tr1xumxmk-ops/CyberCar-main-/infos/Screenshot 2026-10-22 002236.png

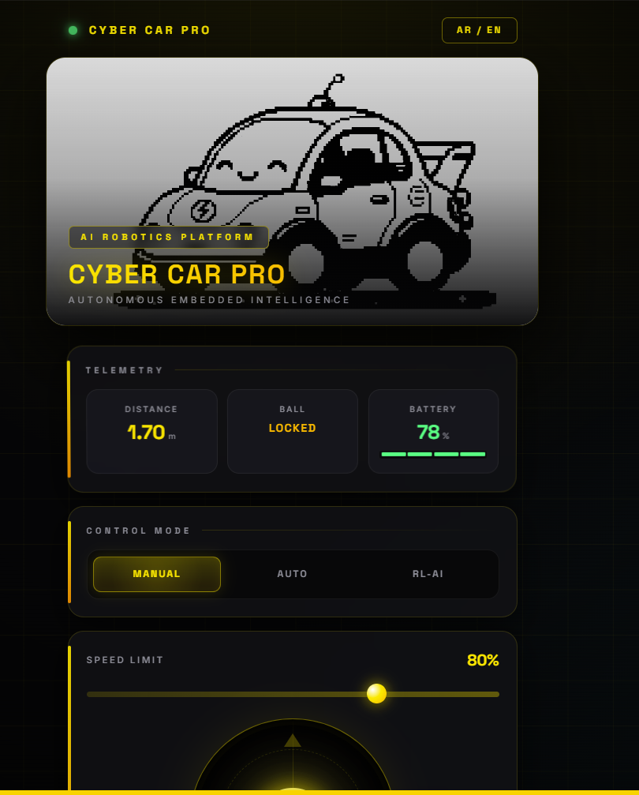
infos/Screenshot 2026-10-22 002236.png
