tr1xumxmk-ops/CyberCar-main-/CyberCar/wiring_handels/CyberCarPro_dashboard_preview.html

CYBER CAR PRO

AR / EN

Cyber Car

AI ROBOTICS PLATFORM

# CYBER CAR PRO

AUTONOMOUS EMBEDDED INTELLIGENCE

TELEMETRY

Distance

--cm

Ball

LOCKED

Battery

--%

CONTROL MODE

MANUAL AUTO RL-AI

Updates

0

Episodes

0

Best Reward

Exploration 50%

SPEED LIMIT 80%

QUICK ACTIONS

RELEASE BALL LOCK BALL HORN DANCE EMERGENCY BRAKE

AL-IRAQIA UNIVERSITY

## AI & ROBOTICS ENGINEERING

Supervised by the SPARK Team — Department of Artificial Intelligence & Robotics

HN

Haider Nadhir

Team Lead

AA

Ahmed Amjad

AI Engineer

BF

Baraa Fadhel

Robotics Engineer

AS

Ayat Saeed

Systems Engineer

Designed & Engineered by AI & Robotics Engineers
© 2026 CYBER CAR PRO — Under SPARK Team Supervision

COMMAND SENT
