tr1xumxmk-ops/CyberCar-main-/CyberCar/wiring_handels/CyberCarPro_Guide (2).html

دليل التوصيل والتشغيل • ESP32-S2

# خلّي Cyber Car Pro تشتغل خطوة بخطوة

دليل عربي عملي لربط المحركات والحساسات والطاقة، ثم رفع البرنامج والاتصال بالسيارة من الموبايل عبر شبكة Wi‑Fi الخاصة بها.

ابدأ بالتوصيلاتربط الموبايل

## ١. القطع المطلوبة

تأكد من وجود هذه القطع قبل البدء.

### 🧠 وحدة التحكم

LOLIN / WEMOS ESP32-S2 Mini، وهي عقل السيارة وتستضيف صفحة التحكم.

### ⚙️ الحركة

درايفر محركات L298N ومحركان DC مع عجلات.

### 📡 استشعار المسافة

حساس HC-SR04 لقياس العوائق أمام السيارة.

### ↔️ السيرفو

عدد ٢ سيرفو SG90 أو MG90S: واحد للمسح، والثاني لآلية تحرير الكرة.

### 🔋 الطاقة

بطارية 2S LiPo بجهد 7.4V ومحوّل خافض إلى 5V بتيار 2A أو أكثر.

### 💡 إضافات

ثلاثة LEDs ومقاومات 220Ω، صفارة، ومقاومتان لقياس جهد البطارية.

سلامة أولاً: افصل البطارية أثناء التوصيل. لا توصل 5V مباشرة إلى أي مدخل GPIO في ESP32، ولا تشغّل السيرفو من رجل 3V3.

## ٢. توصيل الطاقة بشكل صحيح

الطاقة المستقرة والأرضي المشترك يمنعان إعادة تشغيل المتحكم بشكل عشوائي.

بطارية LiPo
7.4V (2S)

←→

درايفر L298N
مدخل طاقة المحركات

بطارية 7.4V

↓

محول خافض Buck
5V / ≥ 2A

### خرج المحوّل 5V

إلى رجل 5V في ESP32-S2، وإلى تغذية السيرفوهات والحساس حسب مواصفات وحداتك.

### الأرضي المشترك GND

اربط سالب البطارية وGND المحوّل وGND الدرايفر وGND المتحكم والحساس والسيرفو معاً.

مهم: لا تربط خرج 5V مع رجل 3V3. تحقق من مخطط لوحة ESP32-S2 Mini التي عندك قبل توصيل الطاقة.

## ٣. جدول توصيل الأسلاك

أرقام GPIO أدناه مطابقة لملف إعدادات المشروع config.h.

رجل ESP32-S2 | تتصل بـ | ملاحظة
GPIO 7 | L298N — IN1 | اتجاه المحرك الأول
GPIO 6 | L298N — IN2 | اتجاه المحرك الأول
GPIO 4 | L298N — IN3 | اتجاه المحرك الثاني
GPIO 5 | L298N — IN4 | اتجاه المحرك الثاني
GPIO 11 | L298N — ENA | PWM للتحكم بالسرعة؛ أزل Jumper ENA
GPIO 12 | L298N — ENB | PWM للتحكم بالسرعة؛ أزل Jumper ENB
GPIO 1 | HC-SR04 — TRIG | إشارة إرسال
GPIO 2 | HC-SR04 — ECHO | عبر مقسّم جهد 5V إلى 3.3V
GPIO 10 | إشارة سيرفو المسح | السلك البرتقالي/الأصفر
GPIO 13 | إشارة سيرفو تحرير الكرة | السلك البرتقالي/الأصفر
GPIO 8 | LED أحمر | مقاومة 220Ω على التوالي
GPIO 9 | LED أخضر | مقاومة 220Ω على التوالي
GPIO 33 | LED أزرق | مقاومة 220Ω على التوالي
GPIO 18 | الطرف الموجب للصفارة | الطرف الآخر إلى GND
GPIO 3 | منتصف مقسّم جهد البطارية | لقياس البطارية؛ لا توصل البطارية مباشرة بالـGPIO

### مقسّم جهد ECHO — ضروري

استخدم مقاومتين: 1kΩ على التوالي بين ECHO ونقطة GPIO2، و2kΩ من نقطة GPIO2 إلى GND. بهذه الطريقة ينخفض جهد إشارة 5V تقريباً إلى 3.3V.

ECHO من الحساس
5V

→ 1kΩ →

نقطة الالتقاء
إلى GPIO 2
ومقاومة 2kΩ إلى GND

ملاحظة للمحركات: وصل المحركين إلى مخارج OUT الخاصة بدرايفر L298N، وليس إلى أرجل ESP32. إذا كان اتجاه الحركة معكوساً، افصل الطاقة وبدّل سلكَي المحرك المعني أو عدّل منطق الاتجاه.

## ٤. رفع البرنامج إلى السيارة

1

نزّل وثبّت Arduino IDE على الحاسبة.

2

من Boards Manager ثبّت حزمة esp32 by Espressif Systems إصدار 3.x.

3

من Library Manager ثبّت مكتبة ESP32Servo.

4

افتح الملف CyberCarPro.ino الموجود داخل مجلد المشروع. اترك الملفات المرافقة مثل config.h وملفات .h في المجلد نفسه.

5

اختر اللوحة LOLIN S2 Mini، وفعّل USB CDC On Boot واختر Default للتقسيم إذا ظهرت الخيارات.

6

صل ESP32 بالحاسبة عبر USB واختر منفذ COM الصحيح، ثم اضغط Upload.

7

افتح Serial Monitor بسرعة 115200 للتأكد من بدء التشغيل وظهور معلومات الجلسة.

إذا لم تُكتشف اللوحة: جرّب ضغط زر 0 باستمرار، اضغط زر RST ضغطة سريعة، ثم اترك زر 0 وجرّب الرفع مجدداً.

## ٥. ربط السيارة بالموبايل

السيارة تنشئ شبكة Wi‑Fi خاصة بها؛ لا تحتاج إلى راوتر أو إنترنت للتحكم المحلي.

### 1 شغّل السيارة

بعد رفع البرنامج، شغّل الطاقة وانتظر حتى تظهر شبكة السيارة في قائمة Wi‑Fi.

### 2 اتصل بالشبكة

اسم الشبكة الافتراضي: Cyber-Car-Pro
كلمة المرور الافتراضية: 12345678

### 3 افتح لوحة التحكم

إذا لم تظهر تلقائياً، افتح المتصفح واكتب: http://192.168.4.1/

### 4 أدخل PIN

الرمز الافتراضي: 1234، ثم افتح واجهة القيادة واختر وضع التشغيل.

### أوضاع القيادة

### Manual — يدوي

تحكم بالاتجاه من عصا القيادة على الشاشة. تتوقف السيارة تلقائياً إذا انقطع أمر التحكم مدة قصيرة.

### Autonomous — ذاتي

تحاول السيارة تفادي العوائق باستخدام حساس المسافة والمسح يميناً ويساراً.

### RL-AI — تعلّم بالتعزيز

تجربة تعليمية مبسطة تتعلم فيها السيارة سلوك تفادي العوائق أثناء الحركة؛ ليست قيادة ذاتية كاملة.

حد الأمان: يمنع البرنامج الحركة للأمام عندما تكون المسافة أقل من 25 سم وفق إعدادات المشروع، لكن هذا ليس بديلاً عن مراقبة السيارة وإيقافها يدوياً عند الحاجة.

غيّر بيانات الدخول قبل العرض: عدّل AP_PASSWORD وPORTAL_PIN داخل config.h. القيم الافتراضية معروفة، وأي شخص متصل بالشبكة ويعرف الرمز قد يستطيع التحكم بالسيارة.

## ٦. إذا واجهتك مشكلة

السيارة تعيد التشغيل عند تحريك المحركات أو السيرفو

تأكد من الأرضي المشترك، واستخدم محوّل 5V بتيار مناسب للسيرفو. لا تغذِّ السيرفو من رجل 3V3.

قراءة المسافة دائماً صفر أو غير مستقرة

راجع توصيل TRIG وECHO، وتأكد أن مقسّم الجهد موجود على ECHO وأن الأرضي مشترك.

شبكة Wi‑Fi لا تظهر

تأكد أن البرنامج رُفع بنجاح وأن اللوحة تعمل. افحص Serial Monitor وتأكد من عدم وجود إعادة تشغيل متكررة بسبب الطاقة.

صفحة التحكم لا تفتح تلقائياً

اتصل بشبكة السيارة ثم افتح http://192.168.4.1/ يدوياً، وجرّب إيقاف بيانات الهاتف مؤقتاً حتى لا ينتقل الهاتف إلى شبكة أخرى.

المحركات لا تتحرك في الوضع اليدوي

حرّك عصا التحكم على الشاشة، وتأكد من توصيل ENA وENB وإزالة الجسور الخاصة بهما، ثم افحص تغذية البطارية والمحركات.

نسبة البطارية المعروضة غير صحيحة

راجع قيم مقاومات مقسّم البطارية وعدّل BATTERY_DIVIDER_RATIO في config.h بعد القياس بمقياس متعدد.

## قائمة فحص قبل التشغيل

- جميع التوصيلات تمت والبطارية مفصولة.
- مقسّم جهد ECHO موصول قبل GPIO2.
- جميع نقاط GND مشتركة.
- السيرفوهات تتغذى من 5V مناسب، وليس من 3V3.
- تم تثبيت ESP32 core 3.x ومكتبة ESP32Servo.
- تم تغيير كلمة مرور الشبكة وPIN الافتراضيين.
- اختُبرت السيارة على الأرض بمساحة خالية وتحت المراقبة.

Cyber Car Pro — دليل توصيل وتشغيل تعليمي. راجع README.md وملف config.h في المشروع إذا اختلفت نسخة اللوحة أو التوصيلات.
