tr1xumxmk-ops/CyberCar-main-/CyberCar/wiring_handels/wiring_diagram.png

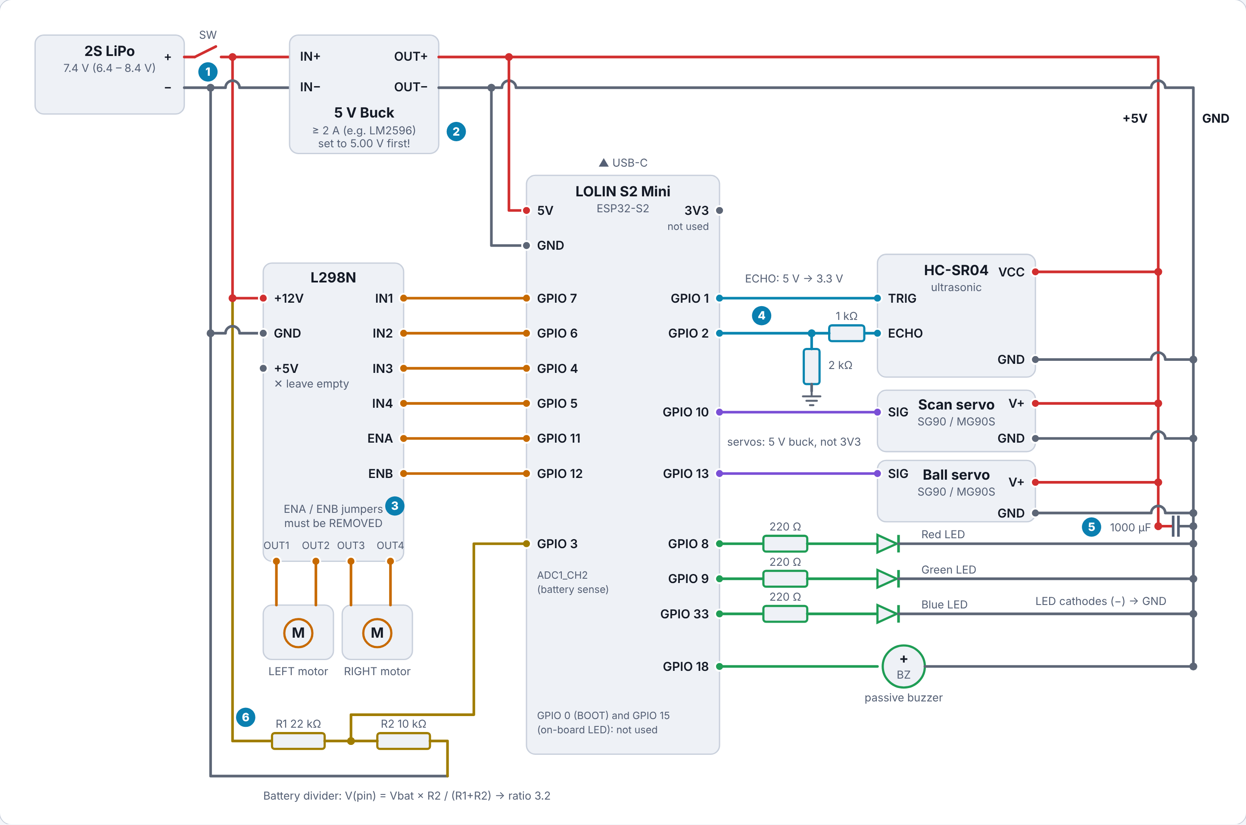
CyberCar/wiring_handels/wiring_diagram.png
