tr1xumxmk-ops/CyberCar-main-/CyberCar/CyberCarPro_optimized/bmp_resource.h

// =============================================================================
// bmp_resource.h — CYBER CAR PRO — BMP header for the embedded image
// =============================================================================
#pragma once
#include <stdint.h>
#include <pgmspace.h>

static constexpr uint16_t IMAGE_WIDTH  = 1408;
static constexpr uint16_t IMAGE_HEIGHT = 768;
static constexpr uint32_t IMAGE_BYTES  = (IMAGE_WIDTH / 8) * IMAGE_HEIGHT;

static const uint8_t BMP_HEADER[62] PROGMEM = {
  0x42, 0x4D,
  0x3E, 0x10, 0x02, 0x00,
  0x00, 0x00, 0x00, 0x00,
  0x3E, 0x00, 0x00, 0x00,
  0x28, 0x00, 0x00, 0x00,
  0x80, 0x05, 0x00, 0x00,
  0x00, 0xFD, 0xFF, 0xFF,
  0x01, 0x00,
  0x01, 0x00,
  0x00, 0x00, 0x00, 0x00,
  0x00, 0x10, 0x02, 0x00,
  0x13, 0x0B, 0x00, 0x00,
  0x13, 0x0B, 0x00, 0x00,
  0x02, 0x00, 0x00, 0x00,
  0x02, 0x00, 0x00, 0x00,
  0x00, 0x00, 0x00, 0x00,
  0xFF, 0xFF, 0xFF, 0x00
};
